RyanCavanaugh/blinds-timer/BOM.md

| Item | Net Price (USD) | Source / Link |
|---|---:|---|
 | **Construction Materials** |
4 yards of blackout cloth | $30 | Local Store
10' 1.25" dia PVC pipe | $5 | Local Store
  | **Electronics** |
1x PIC16F90 MCU (DIP) | $2
4x tactile buttons | $1 | http://www.adafruit.com/products/1119
4x DIP-type LEDs | $1 | From your stash
2x 1uF axial capacitors | $1 | From your stash
1x LED-appropriate resistor | $1 | From your stash
1x high-ohm resistor | $1 | From your stash
4x 1N4001 diode | $1 | http://www.adafruit.com/products/755
1x L293d H-bridge | $3 | http://www.adafruit.com/products/807
1x 12V 500mA DC converter | $3 | Goodwill
1x TO-220 5V voltage regulator | $1 | http://www.adafruit.com/products/2164
1x 4-pin DIP switch | $1 | http://www.amazon.com/dp/B007QAJZLW
1x PCB | $2 | Itead Studio
  | **Motors** |
60 RPM geared DC motor | $13 | http://www.amazon.com/gp/product/B00BX54O8A
DC motor bracket and coupler | $7 | http://www.amazon.com/gp/product/B00KHRIK2G
  | **3d-printed parts** |
Gear for rod | $1
Gear for motor | $1
Mounting bracket | $1
