RyanCavanaugh/blinds-timer/(list of files, cad)

Other CAD files:
firmware/dist/default/production/firmware.production.obj
