RyanCavanaugh/blinds-timer/pcb/Blinds Driver.brd

## EAGLE design pcb/Blinds Driver.brd (2015-06-07)

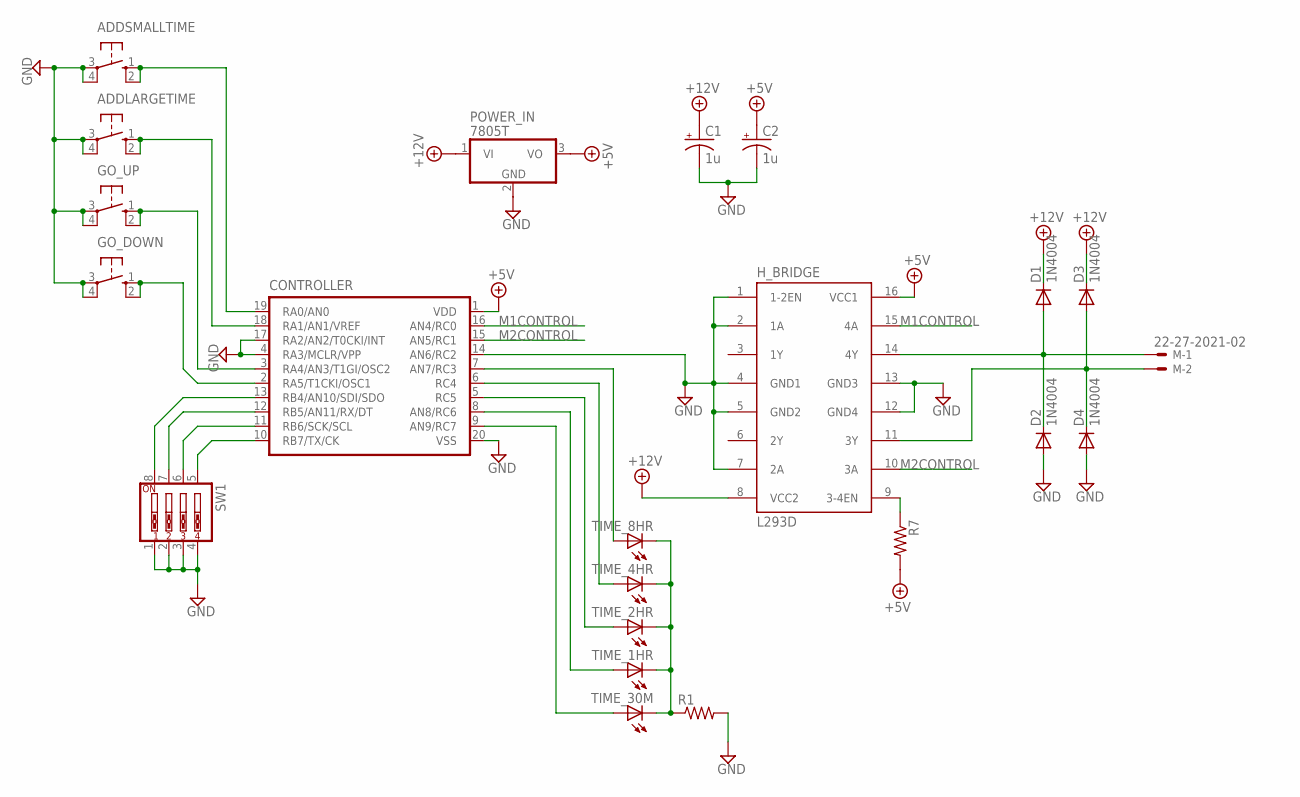
[picture p1: schematic Blinds Driver.sch]

Parts:
ADDLARGETIME: 10-XX; B3F-10XX
ADDSMALLTIME: 10-XX; B3F-10XX
C1, C2: 1u; E2,5-6E
CONTROLLER: PIC16F6XX; DIL20
D1, D2, D3, D4: 1N4004; DO41-10
GO_DOWN: 10-XX; B3F-10XX
GO_UP: 10-XX; B3F-10XX
H_BRIDGE: L293D; DIL16
M: 22-27-2021-02; 6410-02
POWER_IN: 7805T; TO220H
R1, R7: R-US_0207/10; 0207/10
SW1: SW_DIP-4; EDG-04
TIME_1HR, TIME_2HR, TIME_4HR, TIME_8HR, TIME_30M: LED5MM

Connections:
+5V: C2.+, CONTROLLER.1 (VDD), H_BRIDGE.16 (VCC1), POWER_IN.3 (VO), R7.2
+12V: C1.+, D1.C, D3.C, H_BRIDGE.8 (VCC2), POWER_IN.1 (VI)
GND: ADDLARGETIME.3, ADDLARGETIME.4 (P1), ADDSMALLTIME.3, ADDSMALLTIME.4 (P1), C1.-, C2.-, CONTROLLER.4 (RA3/MCLR/VPP), CONTROLLER.14 (AN6/RC2), CONTROLLER.17 (RA2/AN2/T0CKI/INT), CONTROLLER.20 (VSS), D2.A, D4.A, GO_DOWN.3, GO_DOWN.4 (P1), GO_UP.3, GO_UP.4 (P1), H_BRIDGE.1 (1-2EN), H_BRIDGE.2 (1A), H_BRIDGE.4 (GND1), H_BRIDGE.5 (GND2), H_BRIDGE.7 (2A), H_BRIDGE.12 (GND4), H_BRIDGE.13 (GND3), POWER_IN.2 (GND), R1.2, SW1.1, SW1.2, SW1.3, SW1.4
M1CONTROL: CONTROLLER.16 (AN4/RC0), H_BRIDGE.15 (4A)
M2CONTROL: CONTROLLER.15 (AN5/RC1), H_BRIDGE.10 (3A)
unnamed: CONTROLLER.10 (RB7/TX/CK), SW1.5
unnamed: D1.A, D2.C, H_BRIDGE.14 (4Y), M.1
unnamed: CONTROLLER.11 (RB6/SCK/SCL), SW1.6
unnamed: CONTROLLER.12 (RB5/AN11/RX/DT), SW1.7
unnamed: D3.A, D4.C, H_BRIDGE.11 (3Y), M.2
unnamed: CONTROLLER.13 (RB4/AN10/SDI/SDO), SW1.8
unnamed: H_BRIDGE.9 (3-4EN), R7.1
unnamed: CONTROLLER.7 (AN7/RC3), TIME_8HR.A
unnamed: CONTROLLER.6 (RC4), TIME_4HR.A
unnamed: CONTROLLER.5 (RC5), TIME_2HR.A
unnamed: CONTROLLER.8 (AN8/RC6), TIME_1HR.A
unnamed: R1.1, TIME_1HR.K (C), TIME_2HR.K (C), TIME_4HR.K (C), TIME_8HR.K (C), TIME_30M.K (C)
unnamed: ADDSMALLTIME.1 (S), ADDSMALLTIME.2 (S1), CONTROLLER.19 (RA0/AN0)
unnamed: ADDLARGETIME.1 (S), ADDLARGETIME.2 (S1), CONTROLLER.18 (RA1/AN1/VREF)
unnamed: CONTROLLER.3 (RA4/AN3/T1GI/OSC2), GO_UP.1 (S), GO_UP.2 (S1)
unnamed: CONTROLLER.2 (RA5/T1CKI/OSC1), GO_DOWN.1 (S), GO_DOWN.2 (S1)
unnamed: CONTROLLER.9 (AN9/RC7), TIME_30M.A

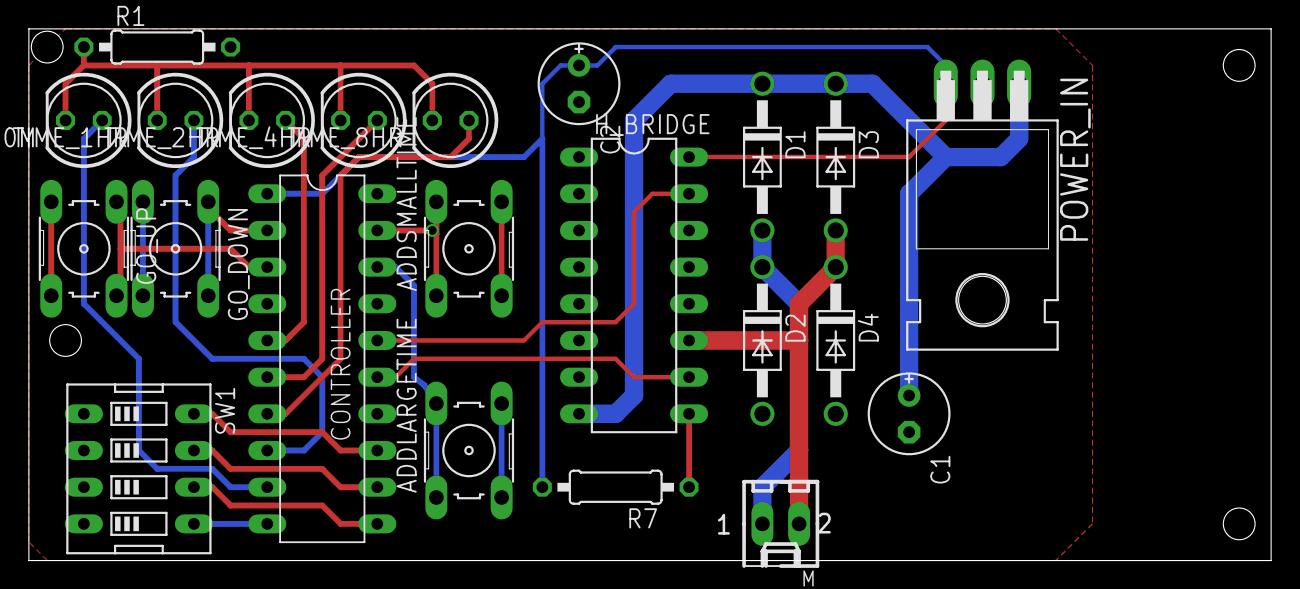
[picture p2: board Blinds Driver.brd from above]

Board: 2 copper layers, 86.0 x 36.8 mm, 22 parts (0 on the bottom side), 22 nets.
