RyanCavanaugh/blinds-timer/(commit log)

2015-05-26 Add brd + sch
    [Blinds Driver.brd, Blinds Driver.sch]
2015-05-26 Miniaturize and remove last via
    [Blinds Driver.brd]
2015-05-26 Slightly smaller, changes holes, improve solderability
    [Blinds Driver.brd]
2015-05-26 Soldering tweak
    [Blinds Driver.brd]
2015-05-26 Standardize trace widths
    [Blinds Driver.brd]
2015-05-26 Fit into smaller PCB! Use 4-pin DIP
    [Blinds Driver.brd, Blinds Driver.sch]
2015-05-26 Improve clearances
    [Blinds Driver.brd]
2015-05-26 More tweaks
    [Blinds Driver.brd]
2015-05-29 1) Diodes were doubled up 2) Only one half-bridge is needed 3) VCC 2 is +12V, VCC1 is +5V 4) Added 2 bypass capacitors on the power supply lines to stabilize power supply
    [Blinds Driver.brd, Blinds Driver.sch]
2015-06-07 Pin A3 is input-only, so use C7 instead
    [Blinds Driver.brd, Blinds Driver.sch]
2015-06-07 Organize into folders, add firmware files
    [Blinds Driver.brd, Blinds Driver.sch, firmware.production.obj]
